sandervonk/CALclock/push/OPNsense/nginx-http-server.png

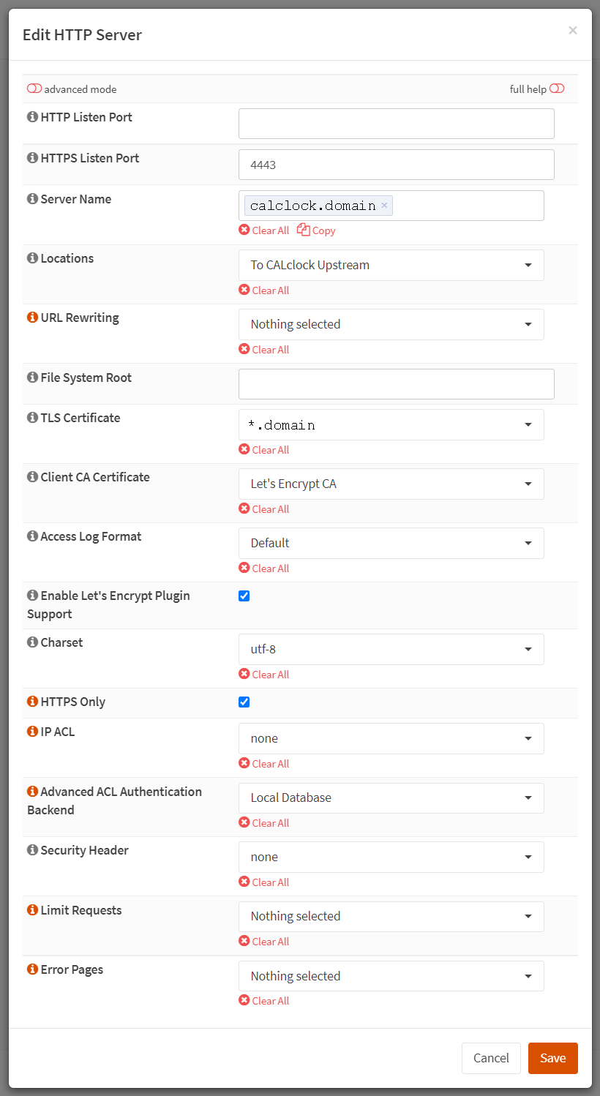
push/OPNsense/nginx-http-server.png
