sandervonk/CALclock/push/OPNsense/nginx-https-location.png

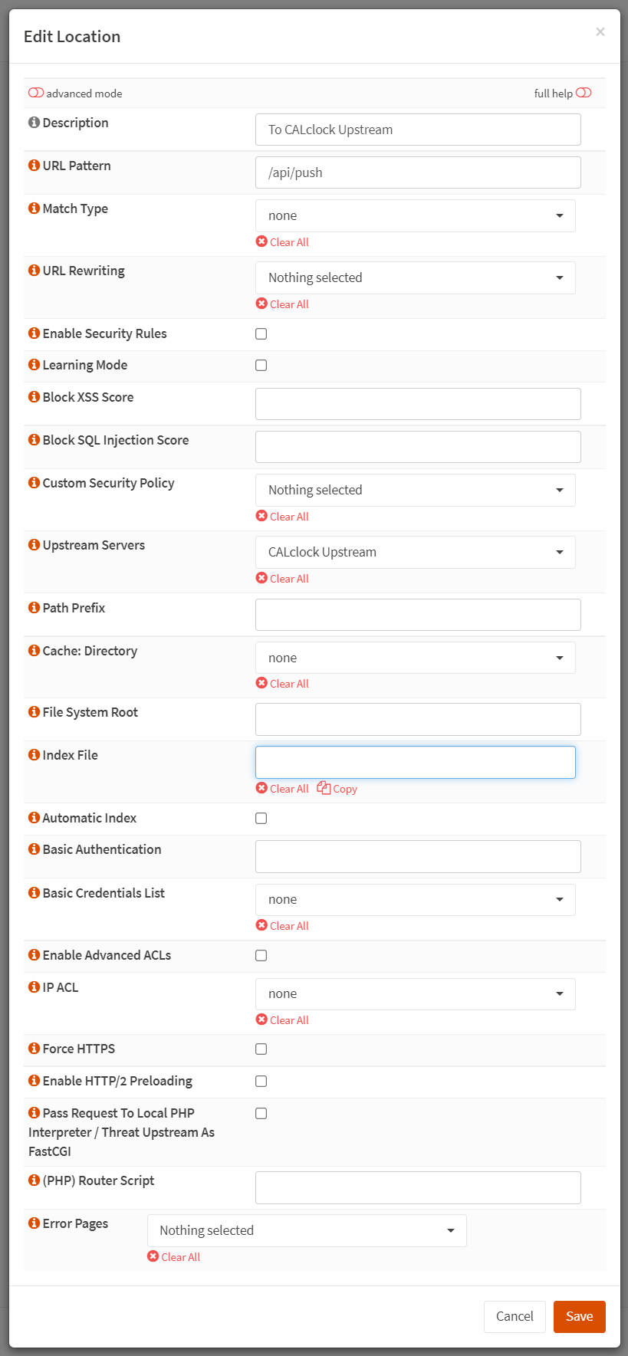
push/OPNsense/nginx-https-location.png
