sandervonk/CALclock/push/OPNsense/nginx-traffic-stats.png

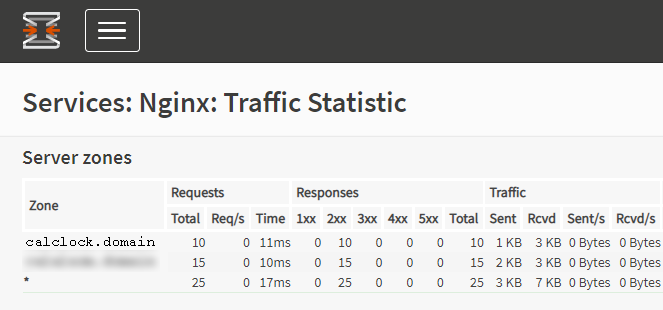
push/OPNsense/nginx-traffic-stats.png
