sandervonk/CALclock/push/OPNsense/nginx-upstream-server.png

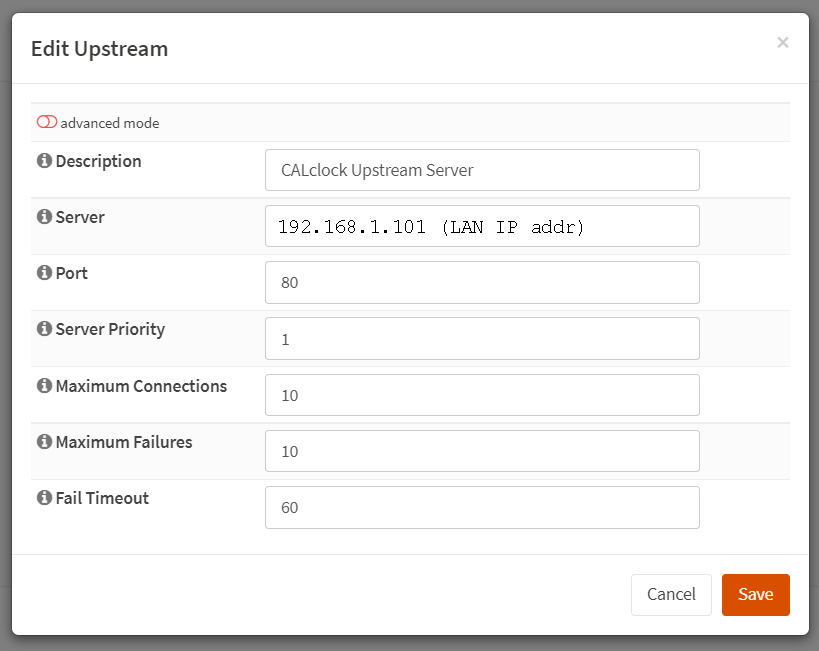
push/OPNsense/nginx-upstream-server.png
