sandervonk/CALclock/push/OPNsense/nginx-upstream.png

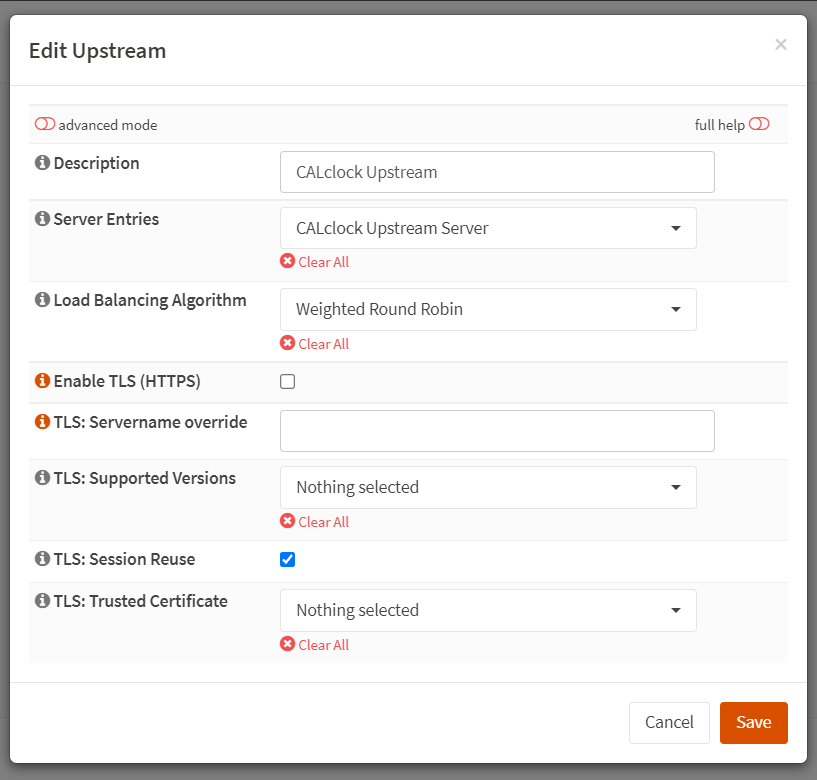
push/OPNsense/nginx-upstream.png
