sandervonk/CALclock/hardware/CALclock-r1.sch

## EAGLE design hardware/CALclock-r1.sch (2022-04-24)

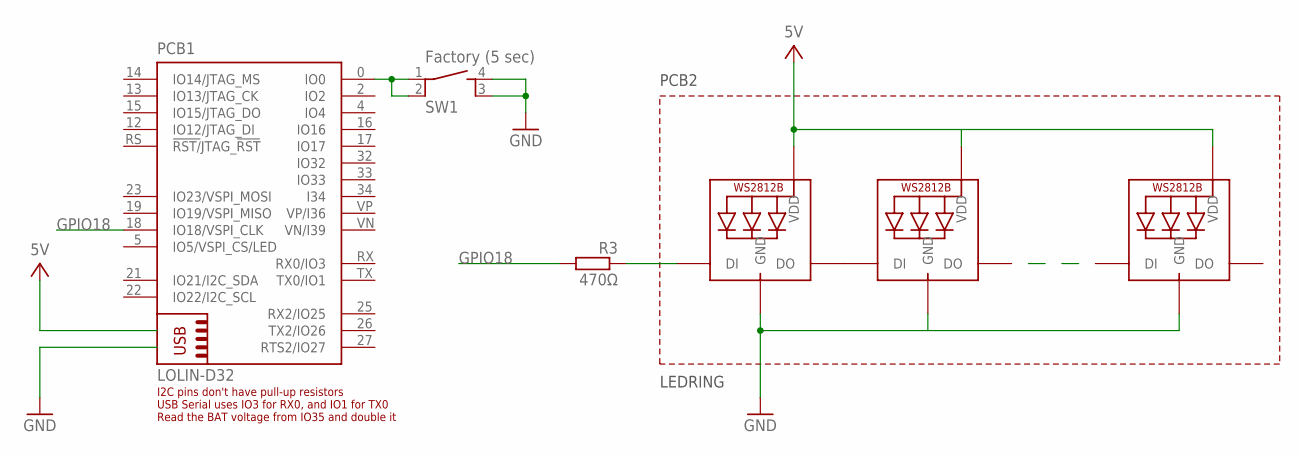
[picture p6: schematic CALclock-r1.sch]

Parts:
LED1, LED2, LED3: WS2812B5050; WS2812B
PCB1: LOLIN-D32
R3: 470Ω; R0805; MOUSER# 652-CRM0805JW1R5ELF
SW1: Factory (5 sec); TE_1-1825910-4

Connections:
5V: LED1.1-VDD (VDD), LED3.1-VDD (VDD)
GND: LED1.3-GND (GND), LED3.3-GND (GND), SW1.3, SW1.4
GPIO18: PCB1.18 (IO18/VSPI_CLK), R3.2
unnamed: LED1.4-DIN (DI), R3.1
unnamed: LED1.2-DOUT (DO), LED2.4-DIN (DI)
unnamed: PCB1.0 (IO0), SW1.1, SW1.2

Notes on the sheet:
PCB2
LEDRING
