sandervonk/CALclock/factory/main/main.c

/**
 * @brief Provision CALclock using a phone app over BLE
 *  
 * Remember to clear the flash memory first.
 *
 * © Copyright 2016, 2022, Sander and Coert Vonk
 * 
 * This file is part of CALclock.
 * 
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
 * CALclock is distributed in the hope that it will be useful, but WITHOUT ANY WARRANTY;
 * without even the implied warranty of MERCHANTABILITY or FITNESS FOR A PARTICULAR PURPOSE.
 * See the GNU General Public License for more details.
 * 
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
 * SPDX-License-Identifier: GPL-3.0-or-later
 */

#include <string.h>
#include <freertos/FreeRTOS.h>
#include <freertos/task.h>
#include <freertos/event_groups.h>
#include <esp_system.h>
#include <esp_wifi.h>
#include <esp_event.h>
#include <esp_log.h>
#include <nvs_flash.h>

#include "wifi_connect.h"
#include "factory_ble_prov.h"
#include "ota_update_task.h"
#include "factory_reset_task.h"

/**
 * _ble_device_name_prefix and BLE_PROV_POP must match build.gradle in the android app;
 * SECURITY_VERSION must correspond to View > Tool Windows > Build Variants > app = bleSec?Debug in
 * Android Studio.
 */
#define BLE_PROV_SECURITY_VERSION (1)
#define BLE_PROV_POP ("bqeL7mTz")
static char const * _ble_device_name_prefix = "POOL_";  // so we can use the OPNpool_provisioning Android app, generic is "PROV_"

static char const * const TAG = "factory";

/* Signal Wi-Fi events on this event-group */
const int WIFI_CONNECTED_EVENT = BIT0;
static EventGroupHandle_t _wifi_event_group;

static struct retry_num {
    uint ap_not_found;
    uint ap_auth_fail;
} _retry_num = {};

static void
_init_nvs(void)
{
    esp_err_t err = nvs_flash_init();
    if (err == ESP_ERR_NVS_NO_FREE_PAGES || err == ESP_ERR_NVS_NEW_VERSION_FOUND) {
        ESP_ERROR_CHECK(nvs_flash_erase());
        err = nvs_flash_init();
    }
    ESP_ERROR_CHECK( err );
}

static void
_start_provisioning(void)
{
    ESP_LOGI(TAG, "Starting BLE provisioning");
    ESP_ERROR_CHECK(ble_prov_start_provisioning(_ble_device_name_prefix, BLE_PROV_SECURITY_VERSION, BLE_PROV_POP));
}

static esp_err_t
_wifi_connect_cb(void * const priv_void, esp_ip4_addr_t const * const ip)
{
    ESP_LOGI(TAG, "IP addr " IPSTR, IP2STR(ip));
    _retry_num.ap_not_found = _retry_num.ap_auth_fail = 0;

    // signal main() that we're connected
    xEventGroupSetBits(_wifi_event_group, WIFI_CONNECTED_EVENT);
    return ESP_OK;
}

static esp_err_t
_wifi_disconnect_cb(void * const priv_void, bool const auth_err)
{
    // signal main() that we're disconnected
    xEventGroupClearBits(_wifi_event_group, WIFI_CONNECTED_EVENT);

    ESP_LOGI(TAG, "retrying connect to WiFi ..");
    return ESP_OK;
}

void app_main(void)
{
    _init_nvs();
    xTaskCreate(&factory_reset_task, "factory_reset_task", 4096, NULL, 5, NULL);

    _wifi_event_group = xEventGroupCreate();

    wifi_connect_config_t wifi_connect_config = {
        .onConnect = _wifi_connect_cb,
        .onDisconnect = _wifi_disconnect_cb,
        .priv = NULL,
    };
    ESP_LOGW(TAG, "Calling wifi_connect_init() ..");
    ESP_ERROR_CHECK(wifi_connect_init(&wifi_connect_config));

    ESP_LOGW(TAG, "Calling ble_prov_is_provisioned() ..");
    bool provisioned;
    if (ble_prov_is_provisioned(&provisioned) != ESP_OK) {
        ESP_LOGE(TAG, "Can't get device prov state");
        return;
    }
    ESP_LOGW(TAG, "Provisioned = %s", provisioned ? "true" : "false");

    if (provisioned) {
        ESP_LOGW(TAG, "Calling wifi_connect_start() ..");
        ESP_ERROR_CHECK(wifi_connect_start(NULL));
    } else {
        ESP_LOGW(TAG, "Calling _start_provisioning() ..");
        _start_provisioning();
        ESP_LOGW(TAG, "Returned from _start_provisioning() ..");
    }

    // wait for WiFi connection
    xEventGroupWaitBits(_wifi_event_group, WIFI_CONNECTED_EVENT, false, true, portMAX_DELAY);

    xTaskCreate(&ota_update_task, "ota_update_task", 8192, "factory", 5, NULL);

    while (1) {
        vTaskDelay(1000 / portTICK_PERIOD_MS);
    }
}
