sandervonk/CALclock/clock/main/display_task.c

/**
 * @brief display_task, received JSON, parses and drive LED circle accordingly
 *
 * © Copyright 2016, 2022, Sander and Coert Vonk
 * 
 * This file is part of CALclock.
 * 
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
 * CALclock is distributed in the hope that it will be useful, but WITHOUT ANY WARRANTY;
 * without even the implied warranty of MERCHANTABILITY or FITNESS FOR A PARTICULAR PURPOSE.
 * See the GNU General Public License for more details.
 * 
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
 * SPDX-License-Identifier: GPL-3.0-or-later
 **/

#include <sdkconfig.h>
#include <math.h>
#include <time.h>
#include <sys/time.h>
#include <string.h>
#include <esp_log.h>
#include <freertos/FreeRTOS.h>
#include <freertos/task.h>
#include <driver/rmt.h>
#include <cJSON.h>

#include <led_strip.h>

#include "display_task.h"
#include "ipc/ipc.h"

#define ARRAYSIZE(a) (sizeof(a) / sizeof(*(a)))
#define ALIGN( type ) __attribute__((aligned( __alignof__( type ) )))
#define PACK( type )  __attribute__((aligned( __alignof__( type ) ), packed ))
#define PACK8  __attribute__((aligned( __alignof__( uint8_t ) ), packed ))
#define MIN(a,b) ({ __typeof__ (a) _a = (a); __typeof__ (b) _b = (b); _a < _b ? _a : _b; })
#define MAX(a,b) ({ __typeof__ (a) _a = (a); __typeof__ (b) _b = (b); _a > _b ? _a : _b; })

static char const * const TAG = "display_task";
static ipc_t * _ipc;

typedef struct {
    time_t start, end;
} PACK8 event_t;

enum MAX_EVENTS { MAX_EVENTS = 30 };
typedef event_t events_t[MAX_EVENTS];

void
sendToDisplay(toDisplayMsgType_t const dataType, char const * const data, ipc_t const * const ipc)
{
    toDisplayMsg_t msg = {
        .dataType = dataType,
        .data = strdup(data)
    };
    assert(msg.data);
    if (xQueueSendToBack(ipc->toDisplayQ, &msg, 0) != pdPASS) {
        ESP_LOGE(TAG, "toDisplayQ full");
        free(msg.data);
    }
}

static time_t
_str2time(char * str) {  // e.g. 2020-06-25T22:30:16.329Z
    struct tm tm;
    if (strptime(str, "%Y-%m-%d %H:%M:%S", &tm) == NULL) {
        ESP_LOGE(TAG, "can't parse time (%s)", str);
        return 0;
    }
    return mktime(&tm);
}

static void  // far from ideal, but it gets the job done
_updateEventDetail(char const * const key,
char * const value,
event_t * const event )
{
    if (strcmp(key, "start") == 0) {
        event->start = _str2time(value);
    } else if (strcmp(key, "end") == 0) {
        event->end = _str2time(value);
    } else {
        ESP_LOGE(TAG, "%s: unrecognized key(%s) ", __func__, key);
    }
}

static void
_setTime(time_t const time)
{
    struct timeval tv = { .tv_sec = time, .tv_usec = 0};
    settimeofday(&tv, NULL);
}

static time_t
_getTime(time_t * time_)
{
    return time(time_);
}

static uint
_json2events(char const * const serializedJson, time_t * const time, events_t events)
{
    uint len = 0;
    if (serializedJson[0] != '{' || serializedJson[strlen(serializedJson)-1] != '}') {
        ESP_LOGW(TAG, "first/last JSON chr ('%c' '%c'", serializedJson[0], serializedJson[strlen(serializedJson)-1]);
        return len;
    }
    cJSON * const jsonRoot = cJSON_Parse(serializedJson);
    if (jsonRoot->type != cJSON_Object) {
        ESP_LOGE(TAG, "JSON root is not an Object");
        return 0;
    }
    cJSON const *const jsonTime = cJSON_GetObjectItem(jsonRoot, "time");
    if (!jsonTime || jsonTime->type != cJSON_String) {
        ESP_LOGE(TAG, "JSON.time is missing or not an String");
        return 0;
    }
    *time = _str2time(jsonTime->valuestring);

    cJSON const *const jsonEvents = cJSON_GetObjectItem(jsonRoot, "events");
    if (!jsonEvents || jsonEvents->type != cJSON_Array) {
        ESP_LOGE(TAG, "JSON.events is missing or not an Array");
        return 0;
    }

    enum DETAIL_COUNT { DETAIL_COUNT = 2 };
    static char const * const detailNames[DETAIL_COUNT] = {"start", "end"};

    event_t * event = events;
    for (int ii = 0; ii < cJSON_GetArraySize(jsonEvents) && ii < MAX_EVENTS; ii++, len++) {

        cJSON const *const jsonEvent = cJSON_GetArrayItem(jsonEvents, ii);
        if (!jsonEvent || jsonEvent->type != cJSON_Object) {
            ESP_LOGE(TAG, "JSON.events[%d] is missing or not an Object", ii);
            return 0;
        }
        for (uint vv = 0; vv < ARRAYSIZE(detailNames); vv++) {
            cJSON const *const jsonObj = cJSON_GetObjectItem(jsonEvent, detailNames[vv]);
            if (!jsonObj || jsonObj->type != cJSON_String) {
                ESP_LOGE(TAG, "JSON.event[%d].%s is missing or not a String", ii, detailNames[vv]);
                return 0;
            }
            _updateEventDetail(detailNames[vv], jsonObj->valuestring, event);
        }
        event++;
    }
    cJSON_Delete(jsonRoot);
    return len;
}

// algorithm from https://en.wikipedia.org/wiki/HSL_and_HSV
static void
_hsv2rgb(uint32_t h, uint32_t s, uint32_t v, uint32_t *r, uint32_t *g, uint32_t *b)
{
    h %= 360;
    uint32_t const rgb_max = v * 2.55f;
    uint32_t const rgb_min = rgb_max * (100 - s) / 100.0f;
    uint32_t const i = h / 60;
    uint32_t const diff = h % 60;
    uint32_t const rgb_adj = (rgb_max - rgb_min) * diff / 60;  // RGB adjustment amount by hue

    switch (i) {
        case 0:
            *r = rgb_max;
            *g = rgb_min + rgb_adj;
            *b = rgb_min;
            break;
        case 1:
            *r = rgb_max - rgb_adj;
            *g = rgb_max;
            *b = rgb_min;
            break;
        case 2:
            *r = rgb_min;
            *g = rgb_max;
            *b = rgb_min + rgb_adj;
            break;
        case 3:
            *r = rgb_min;
            *g = rgb_max - rgb_adj;
            *b = rgb_max;
            break;
        case 4:
            *r = rgb_min + rgb_adj;
            *g = rgb_min;
            *b = rgb_max;
            break;
        default:
            *r = rgb_max;
            *g = rgb_min;
            *b = rgb_max - rgb_adj;
            break;
    }
}

static void
_addEventToStrip(event_t const * const event, time_t const now, uint * const hue, led_strip_t * const strip, bool const flipped)
{
    struct tm nowTm;
    localtime_r(&now, &nowTm);

    float const startsInHr = difftime(event->start, now) / 3600;
    float const endsInHr = difftime(event->end, now) / 3600;
#define DEBUG (1)
#if DEBUG
    struct tm startTm, endTm;
    localtime_r(&event->start, &startTm);
    localtime_r(&event->end, &endTm);
#endif
    uint const hrsOnClock = 12;
    bool const alreadyFinished = endsInHr < 0;
    bool const startsWithin12h = startsInHr < hrsOnClock;

    if (startsWithin12h && !alreadyFinished) {

        float const pxlsPerHr = CONFIG_CALCLOCK_WS2812_COUNT / hrsOnClock;
        float const hrsFromToc = nowTm.tm_hour % hrsOnClock + (float)nowTm.tm_min / 60.0;  // hours from top-of-clock
        uint const nowPxl = round(hrsFromToc * pxlsPerHr);
        uint const startPxl = round((hrsFromToc + MAX(startsInHr, 0)) * pxlsPerHr);
        uint const endPxl = round((hrsFromToc + MIN(endsInHr, hrsOnClock)) * pxlsPerHr);

        for (uint pp = startPxl; pp < endPxl; pp++) {
            uint const minBrightness = 1;
            uint const maxBrightness = flipped ? 50 : 2;
            uint const pct = 100 - (pp - nowPxl) * 100 / CONFIG_CALCLOCK_WS2812_COUNT;
            uint const brightness = minBrightness + (maxBrightness - minBrightness) * pct/100;
            uint r, g, b;
            _hsv2rgb(*hue, 100, brightness, &r, &g, &b);
            uint pxlPos = pp % CONFIG_CALCLOCK_WS2812_COUNT;
            if (flipped) {
                pxlPos = (CONFIG_CALCLOCK_WS2812_COUNT - pxlPos) % 60;
            }
            ESP_ERROR_CHECK(strip->set_pixel(strip, pxlPos, r, g, b));
        }
        uint const goldenAngle = 137;
        *hue = (*hue + goldenAngle) % 360;
    }
}

void
display_task(void * ipc_void)
{
    _ipc = ipc_void;

    // install ws2812 driver
    rmt_config_t config = RMT_DEFAULT_CONFIG_TX(CONFIG_CALCLOCK_WS2812_PIN, RMT_CHANNEL_0);
    config.clk_div = 2;  // set counter clock to 40MHz
    ESP_ERROR_CHECK(rmt_config(&config));
    ESP_ERROR_CHECK(rmt_driver_install(config.channel, 0, 0));
    led_strip_config_t strip_config = LED_STRIP_DEFAULT_CONFIG(CONFIG_CALCLOCK_WS2812_COUNT, (led_strip_dev_t)config.channel);
    led_strip_t * const strip = led_strip_new_rmt_ws2812(&strip_config);
    assert(strip);

    event_t * const events = (event_t *)malloc(sizeof(events_t));
    assert(events);

    uint len = 0;
    time_t now;
    time_t const loopInSec = 60;  // how often the while-loop runs [sec]
    bool const flipped = strcmp(_ipc->dev.name, "calclock-2") == 0;
    while (1) {

        // if there was an calendar update then apply it

        toDisplayMsg_t msg;
        if (xQueueReceive(_ipc->toDisplayQ, &msg, (TickType_t)(loopInSec * 1000 / portTICK_PERIOD_MS)) == pdPASS) {
            len = _json2events(msg.data, &now, events); // translate from serialized JSON "msg" to C representation "events"
            free(msg.data);
            ESP_LOGI(TAG, "Update");
            _setTime(now);
        } else {
            _getTime(&now);
        }

        // loop through each event and set LEDs accordingly

        uint hue = 0;
        event_t const * event = events;
        ESP_ERROR_CHECK(strip->clear(strip, 100));  // turn off all LEDs
        for (uint ee = 0; ee < len; ee++, event++) {
            // build RGB values
            _addEventToStrip(event, now, &hue, strip, flipped);
        }
        // write RGB values to strip driver

        //vTaskSuspend(ipc1Handle);
        ESP_ERROR_CHECK(strip->refresh(strip, 100));
        //vTaskResume(ipc1Handle);

        // 2BD: maybe retry if TIMEOUT ?? instead of restarting ..
    }
}
