sandervonk/CALclock/(commit log)

2022-04-24 add bom
2022-04-24 add schematic
    [CALclock-r1.sch]
