sandervonk/CALclock/(notices)

Notices in the files:
clock/main/display_task.c:
CALclock is free software: you can redistribute it and/or modify it under the terms of
the GNU General Public License as published by the Free Software Foundation, either
